yqzzy/cg2271-pet-care-station/docs/hardware.md

# Hardware worksheet

[Back to project README](../README.md)

## Connections to agree before wiring

| Component | Board | Interface | Pin allocation | Notes |
|---|---|---|---|---|
| Pet button | MCXC444 | GPIO interrupt | 3-pin button module: S on PTD4 (J2-6, D10), middle (+) on 3.3 V (J3-8), - on GND (J2-14) | Active low (module pull-up plus internal pull-up), falling-edge interrupt, debounced in Button_Task. Never power the module from 5 V. Must be on Port A, C or D. Edit the pin block at the top of button.c |
| Water sensor | MCXC444 | ADC | Proposed: PTB2 / ADC0_SE12 / J4 pin 6 | Exposed-track module; verify voltage and measure thresholds. Driver owns ADC0. |
| 1 kg bar load cell and HX711 | MCXC444 | Data/clock GPIO | Proposed: DOUT PTB1 / J4 pin 4; PD_SCK PTB3 / J4 pin 8 | Confirm pins and HX711 availability/logic voltage. Identify load-cell wires from its documentation and mount the bowl rigidly. |
| Temperature/humidity | ESP32-S2 | DHT11 single digital data line | GPIO4 selected; wiring unverified | User-reported 45-in-1 kit module; verify labels, supply/pull-up and exact board. Adafruit DHT library |
| Dispenser: SG90 servo | MCXC444 | Timer/PWM, 50 Hz | PTD2 (J2-4, D9; TPM0_CH2, ALT4). Whole TPM0 reserved for the servo. Red to 5V (J3-10), brown to GND | No driver needed. Gate closed 0 deg (500 us), open 90 deg (1450 us), held open 500 ms per portion (dispenser.c). Re-seat the horn so 0 deg covers the opening. Use a 470 uF capacitor or a separate 5 V supply if the board resets when the servo moves |
| Passive buzzer | MCXC444 | Timer/PWM | PTE21 (TPM1_CH1, ALT3), proposed. Whole TPM1 reserved for the buzzer | Confirm the real buzzer type and pin first (Member 4's test used an active buzzer on PTB0). Cue frequency 2 kHz default. PTE21 is also ADC0_SE4a, so do not use it for an ADC input |
| LED station light | MCXC444 | GPIO/driver | RGB LED module (common cathode): one colour pin on PTD6 (J2-8, D11), - on GND (J2-14) | Active high (LIGHT_ACTIVE_LOW 0 in feedback.c). Add a 220-330 ohm series resistor if the module has none. Edit the light block in feedback.c to move it |
| Board link | Both | UART TX/RX + ground | MCXC444 UART2: TX PTE22, RX PTE23 (ALT4). ESP32: RX pin 2, TX pin 1 (esp32_test.ino) | 9600 baud, 8N1. MCXC444 TX to ESP32 RX, MCXC444 RX to ESP32 TX, common ground. PTE22 and PTE23 are not available for ADC or PWM |

Four input modules are proposed; temperature/humidity is one module. Confirm the pet button counts toward the course's sensor requirement. Never count a module's two measurements as two physical sensors without teaching-team agreement.

## Wiring and assembly

- Verify supply/logic levels and common ground before connecting boards. Do not power a motor directly from a GPIO.
- Select a driver and supply suitable for the actual actuator. Record final pin assignments here and in board-generated configuration.
- Keep weighing mechanics stable and electronics separate from water. The kit water board is for a supervised prototype; evaluate suitability before actual animal use.
- Add wiring photos and circuit diagrams after assembly. Preserve CAD in [the dispenser folder](../hardware/dispenser/README.md).
- Automatic water replenishment is outside the current hardware scope.
