yqzzy/cg2271-pet-care-station/docs/circuit-diagram.png

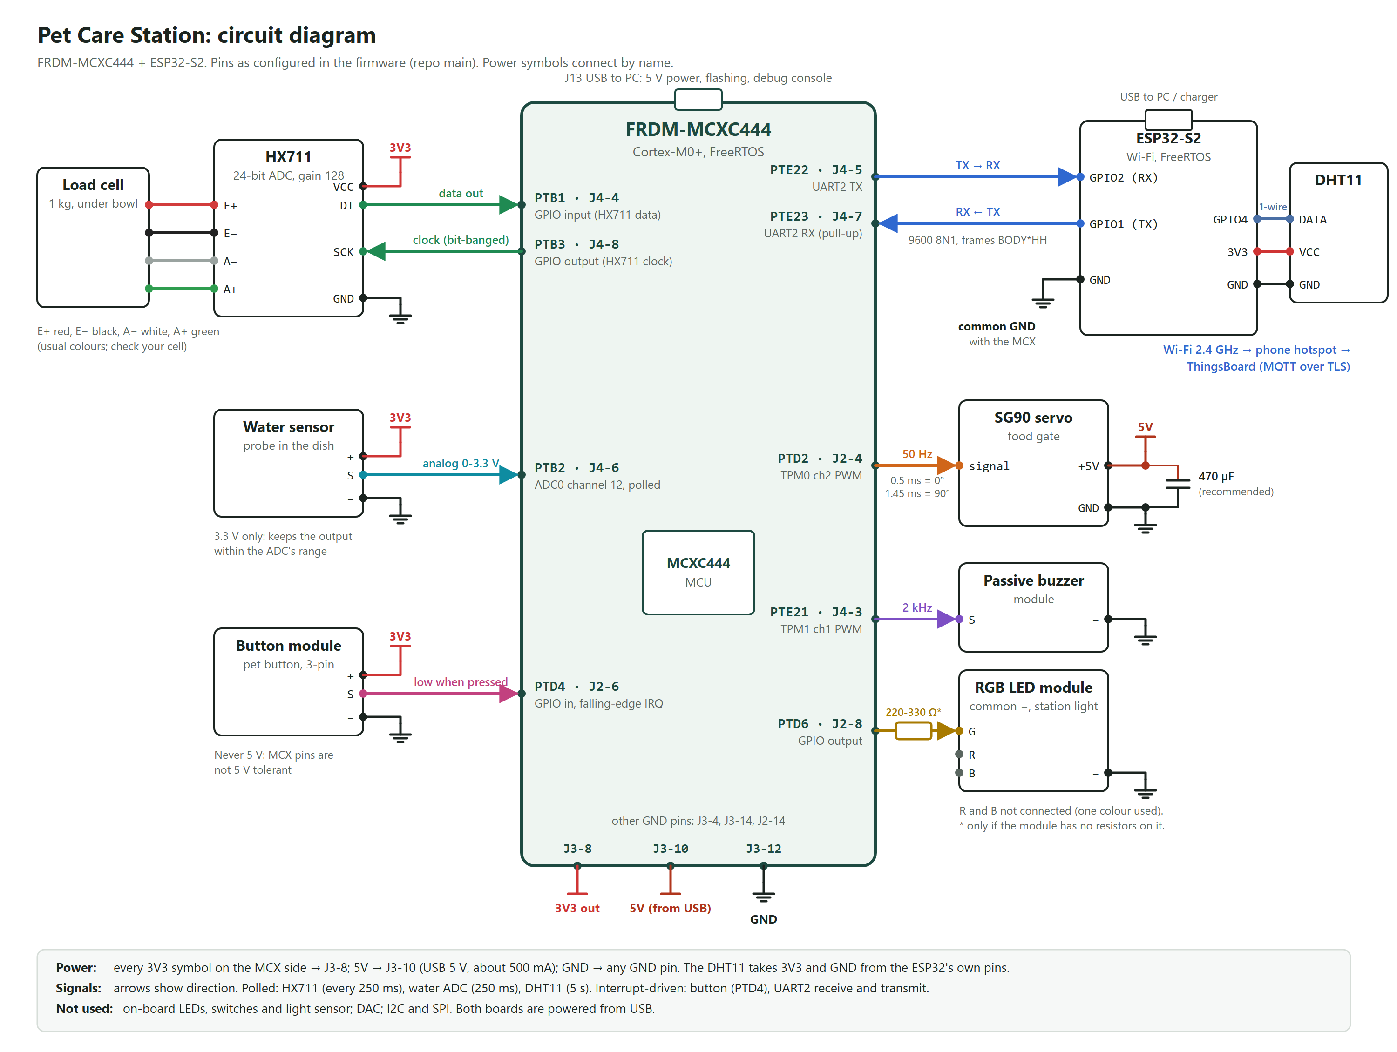
docs/circuit-diagram.png
