yqzzy/cg2271-pet-care-station/mcuxpresso/pet-station/source/pet-station.c

/*
 * Copyright 2016-2026 NXP
 * All rights reserved.
 *
 * SPDX-License-Identifier: BSD-3-Clause
 */

/**
 * @file    pet-station.c
 * @brief   Application entry point.
 */
#include "board.h"
#include "peripherals.h"
#include "pin_mux.h"
#include "clock_config.h"
#include "fsl_debug_console.h"
#include "app/rtos_setup.h"
#include "app/servo_test.h"

/*
 * @brief   Application entry point.
 */
int main(void) {

    /* Init board hardware. */
    BOARD_InitBootPins();
    BOARD_InitBootClocks();
    BOARD_InitBootPeripherals();
#ifndef BOARD_INIT_DEBUG_CONSOLE_PERIPHERAL
    /* Init FSL debug console. */
    BOARD_InitDebugConsole();
#endif

#if SERVO_TEST_ONLY
    /* Bench test: servo console only (app/servo_test.c), never returns */
    ServoTest_Run();
#endif

    /* Initialize application objects and tasks, then start FreeRTOS. */
    Rtos_Start();

    /* Stop if the scheduler cannot start. */
    for (;;) { }
}
