yqzzy/cg2271-pet-care-station/firmware/mcxc444/control/actuator_task.h

/*
 * File: actuator_task.h
 * Owner: Member 1
 */
#ifndef ACTUATOR_TASK_H
#define ACTUATOR_TASK_H

void Actuator_Task(void *argument);     /* FreeRTOS task entry point */

#endif /* ACTUATOR_TASK_H */
