yqzzy/cg2271-pet-care-station/firmware/esp32/pet_care_station/cloud_client.h

#ifndef PET_CARE_CLOUD_CLIENT_H
#define PET_CARE_CLOUD_CLIENT_H

// Check local configuration and prepare TLS/MQTT resources without connecting.
// False disables cloud startup; environment sensing can still run.
bool Cloud_Init(void);
// Create exactly one task after successful Cloud_Init. Owns all network clients.
// Publishes fresh DHT11/UART sensor snapshots periodically; no RPC/events yet.
void Cloud_Task(void *argument);

#endif
