yqzzy/cg2271-pet-care-station/(commit log)

2026-10-23 Initial Setup for Environment Sensor
2026-10-23 Add MCXC444 and ESP32 UART modules with public API documentation
2026-11-02 Implement water sensor task
2026-11-04 Update sensor implementation and integration documentation
2026-11-04 Add SG90 servo dispenser and actuator task
    - dispenser.c/.h: non-blocking SG90 gate cycle on TPM0_CH2 (PTD2, proposed),
    50 Hz PWM; open 500 ms, close, 300 ms settle. Busy requests are rejected and
    never extend a running cycle. Angles and times are placeholders until the
    mechanism is built.
    - actuator_task.c/.h: Actuator_Task replaces the test stand-in. Handles beep
    and dispense commands, polls consumeLight() every 20 ms, wakes for buzzer
    and servo deadlines, reports TEL_DISPENSE_RESULT and plays the food-ready
    cue only after a completed cycle.
    - rtos_setup.c: disable TestActuator_Task, register Actuator_Task, call
    Dispenser_Init() after Feedback_Init() (shared TPM clock).
    - foo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
    [actuator_task.c, actuator_task.h, dispenser.c, dispenser.h, food_sensor.c, rtos_setup.c]
2026-11-06 MQTT between ESP32 and Cloud
2026-11-06 Calibrate the food load cell and fix rejected weights
    Enter the measured HX711 calibration (empty bowl 64436 counts, plus 80 g
    7132 counts, about 716 counts per gram; counts fall as weight is added)
    and set FOOD_CALIBRATED to 1.
    Fix the plausibility check: Redlib defines INT32_MIN as (-0x80000000),
    an unsigned int, so "result < INT32_MIN" compared against +2147483648 and
    rejected every weight. Cast it to int32_t.
    Verified on hardware: the empty bowl reads about -1 g, the MCXC444 now
    sends SENSOR packets every second and the ESP32 publishes food_weight_g.
    Automatic feeding stays disabled (FOOD_FEEDING_ENABLED 0).
    [food_sensor.c]
2026-11-06 Enable automatic feeding at 10 g
    Request one portion once the filtered food weight stays at or below 10 g
    for three samples. The next request needs the bowl to reach 20 g again
    (rearm) and at least 10 s to pass.
    Verified on hardware: with an empty bowl, exactly one dispense ran after
    start-up and no further request followed.
2026-11-09 Add the ESP32 fixes needed before the Week 13 demo
    Lists what Members 4 and 5 need to do on the ESP32, mapped to the demo
    rubric: push the missing PetStationUart library and live_telemetry.h,
    consume button events so BUTTON_ACK is sent, forward ThingsBoard RPC
    light commands to the MCXC444, finish the dashboard and alarms, and fix
    the demo-day Wi-Fi. Each task has the expected serial output on both
    boards.
2026-11-09 Implement ESP32 button acknowledgements and ThingsBoard light control
2026-11-09 Document current UART contract and verified ESP32 builds
2026-11-09 Publish telemetry early when food or water changes
    The dashboard lagged the bowl by up to about 7 s because the ESP32 only
    published every 5 s. Keep the 5 s period, but also publish as soon as
    the MCU readings change noticeably: water flips, food moves by 2 g or
    more, or MCU data appears or disappears. Early publishes are limited to
    one per second, so pouring food does not flood ThingsBoard.
    The change test is hardware-independent (McuChangedNotably in
    live_telemetry) and covered in live_telemetry_test, including the 2 g
    boundary, removal, data loss, extreme values and millis() rollover.
    cloud_client.cpp could not be compiled on this PC (no Arduino ESP32
    toolchain); please build and flash t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
    [cloud_client.cpp, live_telemetry.cpp, live_telemetry.h, live_telemetry_test.cpp]
2026-11-09 Finish the MCXC444 for the demo: top-up feeding, external I/O, fixes
    Feeding: replace the single-request latch with a top-up state machine
    in food_sensor.c. At 10 g or less (three samples) it requests one
    portion, waits for the actuator task to give the new binary semaphore
    dispenseDoneSem when the gate closes, lets the food settle for 1.5 s,
    and repeats until the bowl is above 20 g. A 10 s eating-time lockout
    follows. Each portion is logged ([feed] ...) for tuning.
    Dispenser: gate closed at 0 deg (500 us), open at 90 deg (1450 us),
    500 ms per portion. The settings can be changed at run time by the
    bench tool.
    Load cell: new calibration after the excitation wiring fix (36 g
    reference, abou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
    [actuator_task.c, button.c, dispenser.c, dispenser.h, feedback.c, food_calibration.c, food_calibration.h, food_sensor.c]
2026-11-11 Recalibrate the load cell after the mechanical rework
    The rework took weight off the load cell, so the empty bowl read about
    -8 to -10 g, below the -5 g validity limit. Every food reading was
    rejected, which stopped both the UART sensor reports and feeding.
    New calibration from the bench tool: 47 g reference (about 717 counts
    per gram), zero taken with the 47 g bowl mounted. Verified on the
    board: the empty bowl reads 0.1 g, sensor packets resume, and one
    top-up portion took the bowl from 0 to 24.3 g.
    [food_sensor.c]
2026-11-13 Add the full circuit diagram
    Schematic of the whole station as SVG, plus a PNG for the final
    report: load cell and HX711, water sensor and button module into the
    FRDM-MCXC444; servo, buzzer and RGB LED driven by it; the UART2 link
    to the ESP32-S2, which reads the DHT11. Pins and peripherals match the
    firmware on main; power uses 3V3/5V/GND symbols joined by name.
